MrModd/soil-hygrometer/(commit log)

2025-03-07 Turn on the LED only when waiting for the button press
2025-03-08 Adjusted the min working battery voltage
2025-03-12 Added MOSFET board to cut the sensor power
2025-03-13 fix: power up the sensor before reading the battery level
    The sensor influences significantly the battery level readings.
    The estimated increase in power consumption, considering anticipating
    the power up of the sensor, is in the order of few uAh.
    [soil-hygrometer.ino]
